FrankenVoron/FT-V/README.md

# FT-V
An unholy mixture of Vorons past and present; a printer only Frankenstein could love.

FT-V
