FrankenVoron/FT-V/FT-V/README.md

# FT-V

The FT-V is a printer born of frustration.

The Folgertech FT-5 is a printer that, by all accounts, was destined for greatness. Numerous design flaws make it mediocre at best, with many pieces needing to be replaced before even the questionably designed internal space can be put to good use.

The machine described in these files is what the FT-5 could have been.

We present... the FrankenVoron. The FT-V.

FT-V
