FrankenVoron/FT-V/FT-V/Phase 2 (Bed Upgrade)/README.md

# FT-V Phase 2 Upgrade
[FT-V BOM Link](https://docs.google.com/spreadsheets/d/1DAGFSrG05QE8Q3-KJ5_f3gPs6uIrWfWeZ_tS3dDz_z8/edit?usp=sharing)
($150 + Phase 1 Cost)
     
     -Replaces warped and underpowered FT-5 bed with MIC6/ATP5 Cast Aluminum Tooling Plate and AC Silicone Heater
     
     -Replaces weak ACM or Melamine bed support with frame from 2020 extrusions
     
     -Utilize up to 360x340mm bed area
