FrankenVoron/FT-V/FT-V/Phase 3 (Z Rod Upgrade)/README.md

# FT-V Phase 3 Upgrade
[FT-V BOM Link](https://docs.google.com/spreadsheets/d/1DAGFSrG05QE8Q3-KJ5_f3gPs6uIrWfWeZ_tS3dDz_z8/edit?usp=sharing)
($100 + Phase 2 + Phase 1)

UNDER DEVELOPMENT
     
     -Upgraded Z Axis
     
     -Improve stability of bed in fore/aft position
     
     -8mm->12mm linear rods and lead screws
     
     -Bed/Z axis changed from Volcom's V1.5 mod to V1.6 style
     
     -Potential to switch to 3 lead screws tied together.
