FrankenVoron/FT-V/FT-V/Phase 1 (CoreXY + Bowden)/Firmware/README.md

# FT-V Firmware

All firmware samples provided are not customized to your printer. Use as a reference only
