FrankenVoron/FT-V/FT-V/Phase 1 (CoreXY + Bowden)/STLs/Bed (V1.5 Volcom Mod)/README.md

# FT-V

This part secures the top of the 8mm linear rods used for the Z axis to the extrusions that the Y rails sit on. 

This design is inspired by the Voron V1.5 "Volcom Mod" design.

Note: This part is different than the one used by Phase 2.
