FrankenVoron/FT-V/FT-V/Phase 1 (CoreXY + Bowden)/STLs/Bed (V1.5 Volcom Mod)/Z_Shaft_Upper_Support_8mm_StandardBed_x4 FT-V.stl

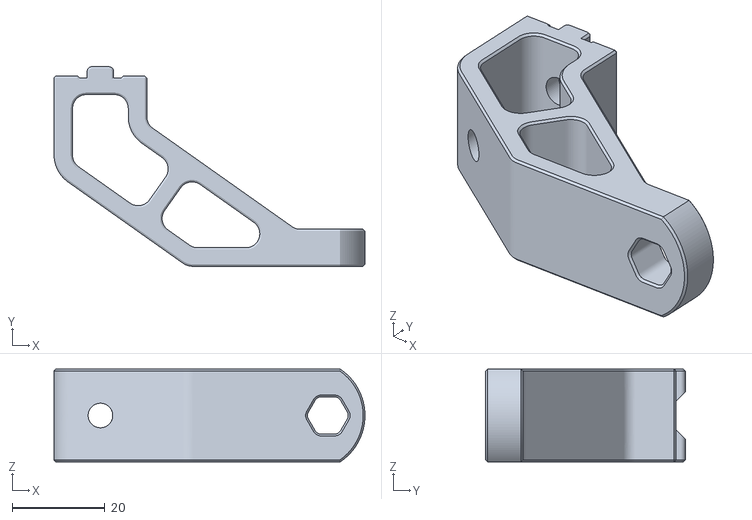
[picture p1: CAD file, 2019-07-24]
FT-V/Phase 1 (CoreXY + Bowden)/STLs/Bed (V1.5 Volcom Mod)/Z_Shaft_Upper_Support_8mm_StandardBed_x4 FT-V.stl
67.0 x 43.0 x 20.0
