FrankenVoron/FT-V/FT-V/Phase 1 (CoreXY + Bowden)/STLs/Gantry (V1.6 and V2.1)/_pulley_spacer_x4.stl

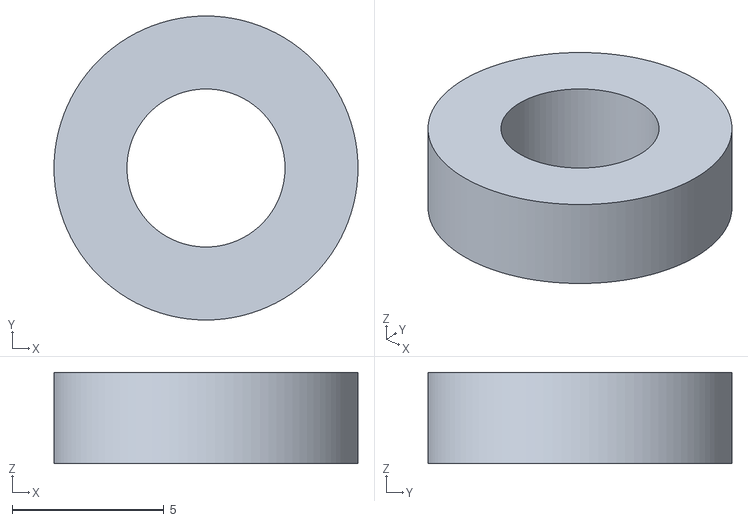
[picture p2: CAD file, 2019-07-24]
FT-V/Phase 1 (CoreXY + Bowden)/STLs/Gantry (V1.6 and V2.1)/_pulley_spacer_x4.stl
10.0 x 10.0 x 3.00
