FrankenVoron/FT-V/FT-V/Phase 1 (CoreXY + Bowden)/STLs/Gantry (V1.6 and V2.1)/AB Drives (V1.6 Mod)/A_Drive_Lower FT-V.stl

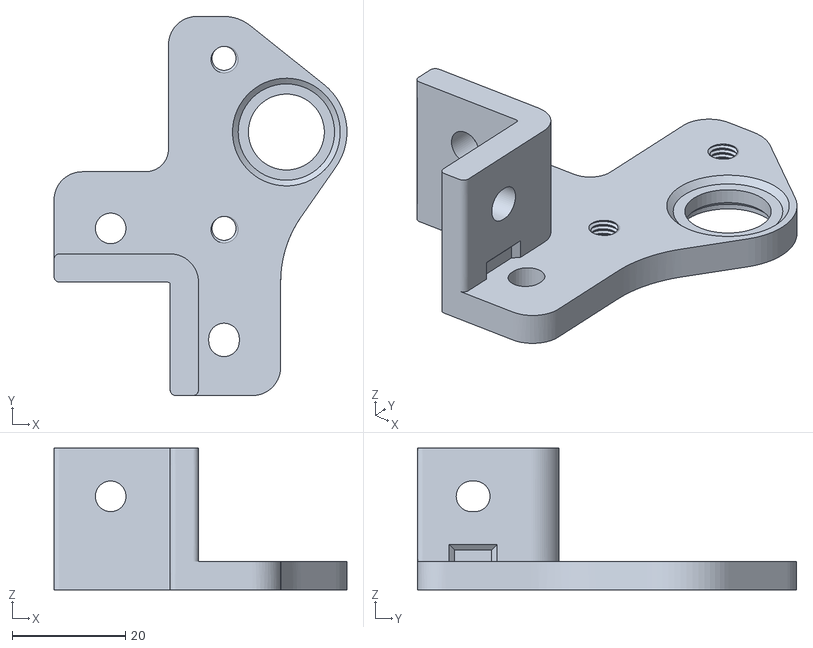
[picture p3: CAD file, 2019-07-24]
FT-V/Phase 1 (CoreXY + Bowden)/STLs/Gantry (V1.6 and V2.1)/AB Drives (V1.6 Mod)/A_Drive_Lower FT-V.stl
51.7 x 66.9 x 25.0
