FrankenVoron/FT-V/FT-V/Phase 1 (CoreXY + Bowden)/STLs/Gantry (V1.6 and V2.1)/X Carriage (V2.1 Mod)/Toolhead/Mosquito Hotend Sock/mosquito_sock_mold_top.stl

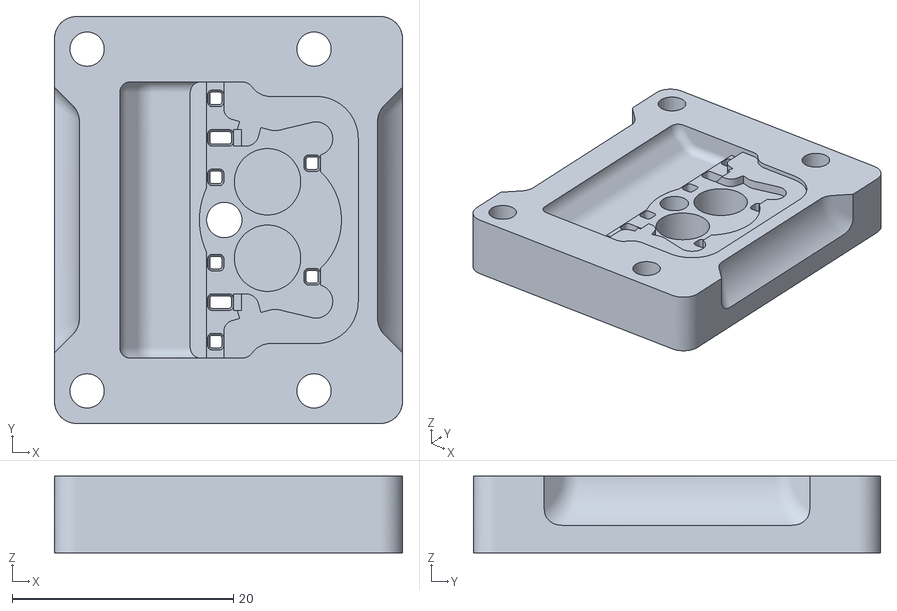
[picture p5: CAD file, 2019-07-24]
FT-V/Phase 1 (CoreXY + Bowden)/STLs/Gantry (V1.6 and V2.1)/X Carriage (V2.1 Mod)/Toolhead/Mosquito Hotend Sock/mosquito_sock_mold_top.stl
31.5 x 36.8 x 6.95
