FrankenVoron/FT-V/FT-V/Phase 1 (CoreXY + Bowden)/STLs/Gantry (V1.6 and V2.1)/X Carriage (V2.1 Mod)/Toolhead/v6_toolhead_housing_rear.STL

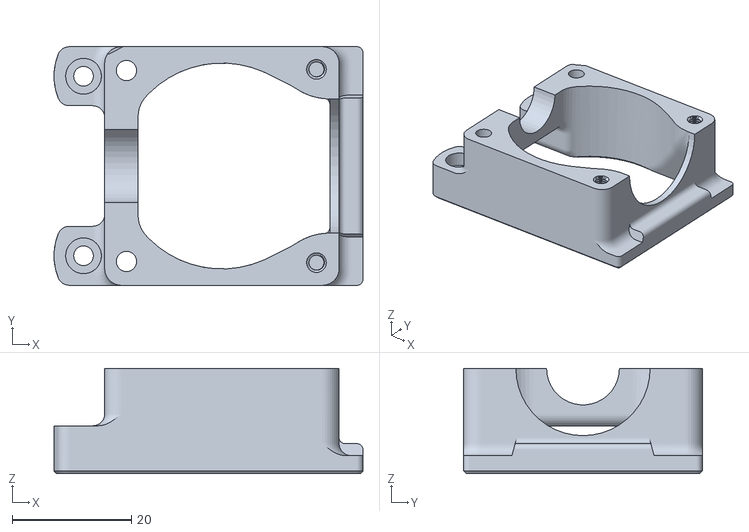
[picture p6: CAD file, 2019-07-24]
FT-V/Phase 1 (CoreXY + Bowden)/STLs/Gantry (V1.6 and V2.1)/X Carriage (V2.1 Mod)/Toolhead/v6_toolhead_housing_rear.STL
51.8 x 40.0 x 17.6
