FrankenVoron/FT-V/FT-V/Phase 1 (CoreXY + Bowden)/STLs/Gantry (V1.6 and V2.1)/X Carriage (V2.1 Mod)/X_Carriage_Frame_Left FT-V.stl

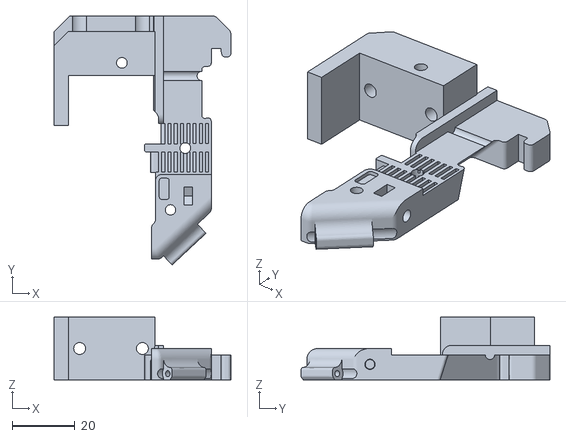
[picture p7: CAD file, 2019-07-24]
FT-V/Phase 1 (CoreXY + Bowden)/STLs/Gantry (V1.6 and V2.1)/X Carriage (V2.1 Mod)/X_Carriage_Frame_Left FT-V.stl
56.4 x 79.4 x 20.0
