FrankenVoron/FT-V/FT-V/Phase 1 (CoreXY + Bowden)/STLs/Gantry (V1.6 and V2.1)/XY Joints (V2.1 Mod)/XY_Joint_backbrace_left FT-V.stl

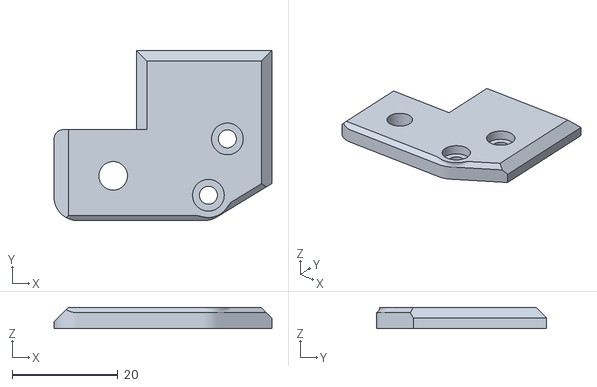
[picture p8: CAD file, 2019-07-24]
FT-V/Phase 1 (CoreXY + Bowden)/STLs/Gantry (V1.6 and V2.1)/XY Joints (V2.1 Mod)/XY_Joint_backbrace_left FT-V.stl
41.3 x 32.2 x 4.00
