FrankenVoron/FT-V/FT-V/Phase 2 (Bed Upgrade)/STLs/Bed (V1.5 Volcom Mod)/Z_Shaft_Upper_Support_8mm_Phase2_x4 FT-V.stl

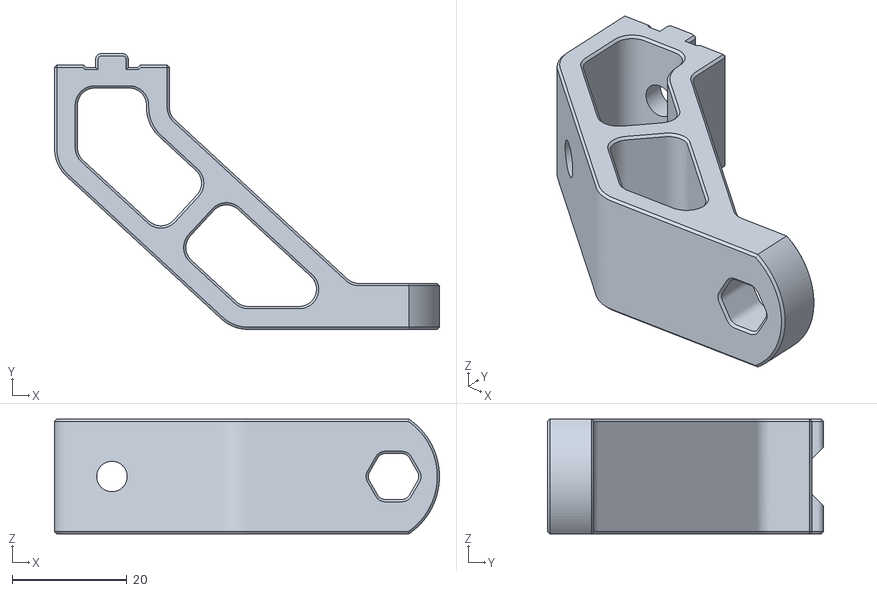
[picture p9: CAD file, 2019-07-24]
FT-V/Phase 2 (Bed Upgrade)/STLs/Bed (V1.5 Volcom Mod)/Z_Shaft_Upper_Support_8mm_Phase2_x4 FT-V.stl
67.0 x 48.0 x 20.0
