FrankenVoron/FT-V/FT-V/Phase X (Optional Upgrades and Mods)/Direct Drive BMG/Direct_Drive_BMG_Mount_15mm_Offset.stl

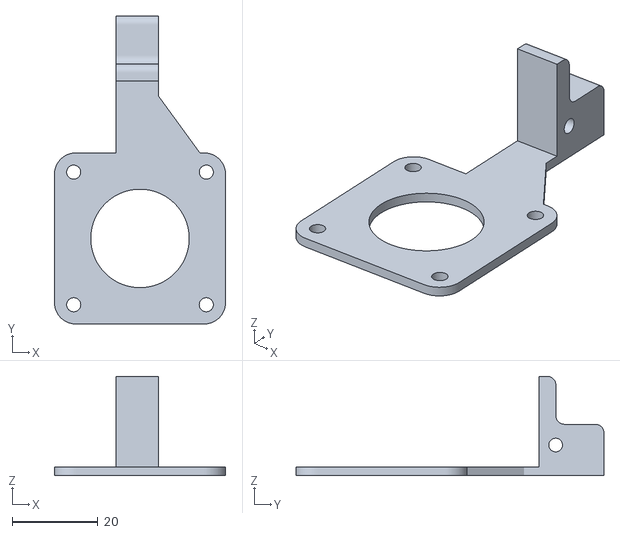
[picture p10: CAD file, 2019-08-08]
FT-V/Phase X (Optional Upgrades and Mods)/Direct Drive BMG/Direct_Drive_BMG_Mount_15mm_Offset.stl
40.0 x 72.0 x 23.2
