FrankenVoron/FT-V/FT-V/Phase 1 (CoreXY + Bowden)/STLs/Gantry (V1.6 and V2.1)/AB Drives (V1.6 Mod)/A_Drive_Upper FT-V.stl

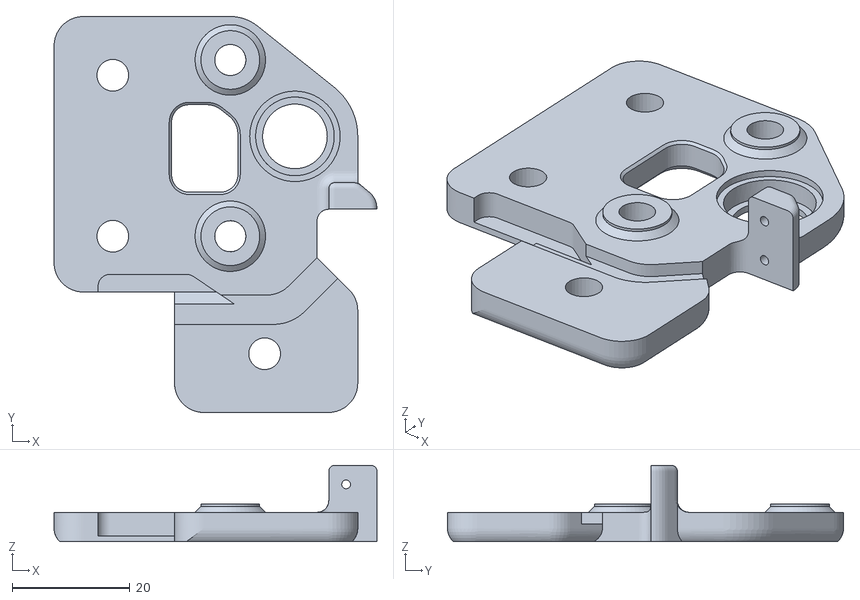
[picture p11: CAD file, 2019-07-24]
FT-V/Phase 1 (CoreXY + Bowden)/STLs/Gantry (V1.6 and V2.1)/AB Drives (V1.6 Mod)/A_Drive_Upper FT-V.stl
55.0 x 67.4 x 13.0
