FrankenVoron/FT-V/FT-V/Phase 1 (CoreXY + Bowden)/STLs/Gantry (V1.6 and V2.1)/Front Idlers (V2.1 Mod)/_front_tensioner_cap_lower_right.stl

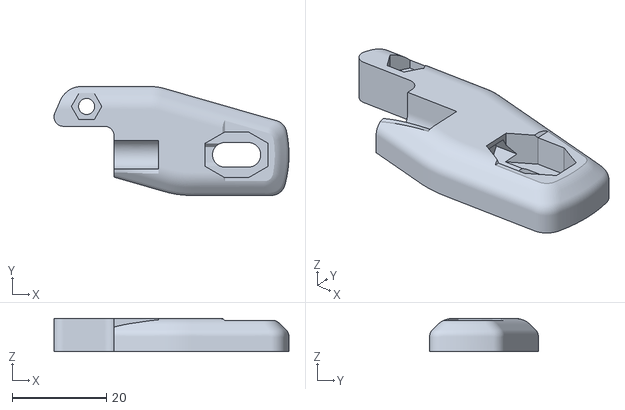
[picture p12: CAD file, 2019-07-24]
FT-V/Phase 1 (CoreXY + Bowden)/STLs/Gantry (V1.6 and V2.1)/Front Idlers (V2.1 Mod)/_front_tensioner_cap_lower_right.stl
49.8 x 23.1 x 7.00
