FrankenVoron/FT-V/FT-V/Phase 1 (CoreXY + Bowden)/STLs/Gantry (V1.6 and V2.1)/X Carriage (V2.1 Mod)/Toolhead/Mosquito Hotend Sock/mosquito_sock_core_top.stl

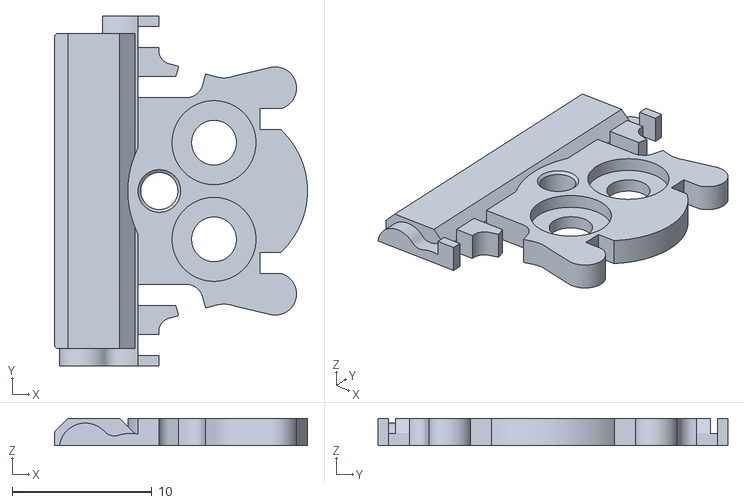
[picture p14: CAD file, 2019-07-24]
FT-V/Phase 1 (CoreXY + Bowden)/STLs/Gantry (V1.6 and V2.1)/X Carriage (V2.1 Mod)/Toolhead/Mosquito Hotend Sock/mosquito_sock_core_top.stl
18.1 x 25.0 x 1.96
