FrankenVoron/FT-V/FT-V/Phase 1 (CoreXY + Bowden)/STLs/Gantry (V1.6 and V2.1)/X Carriage (V2.1 Mod)/Toolhead/volcano_cooling_fan_duct_left.STL

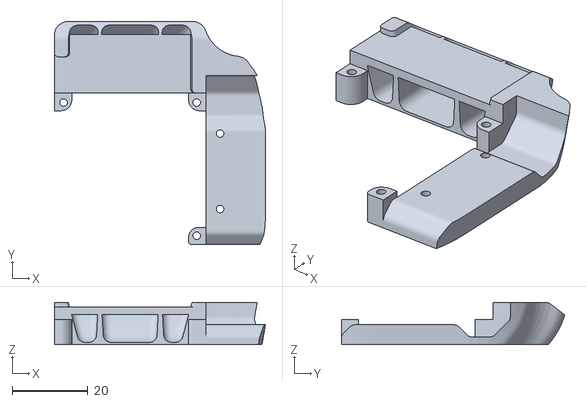
[picture p15: CAD file, 2019-07-24]
FT-V/Phase 1 (CoreXY + Bowden)/STLs/Gantry (V1.6 and V2.1)/X Carriage (V2.1 Mod)/Toolhead/volcano_cooling_fan_duct_left.STL
55.8 x 59.1 x 11.1
