FrankenVoron/FT-V/FT-V/Phase 1 (CoreXY + Bowden)/STLs/Gantry (V1.6 and V2.1)/XY Joints (V2.1 Mod)/xy_joint_backbrace_right.stl

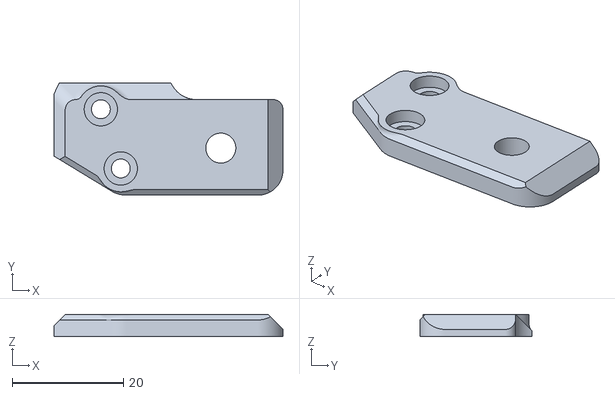
[picture p17: CAD file, 2019-07-24]
FT-V/Phase 1 (CoreXY + Bowden)/STLs/Gantry (V1.6 and V2.1)/XY Joints (V2.1 Mod)/xy_joint_backbrace_right.stl
41.3 x 20.2 x 4.00
