FrankenVoron/FT-V/FT-V/Phase X (Optional Upgrades and Mods)/Direct Drive BMG/Direct_Drive_BMG_Mount.stl

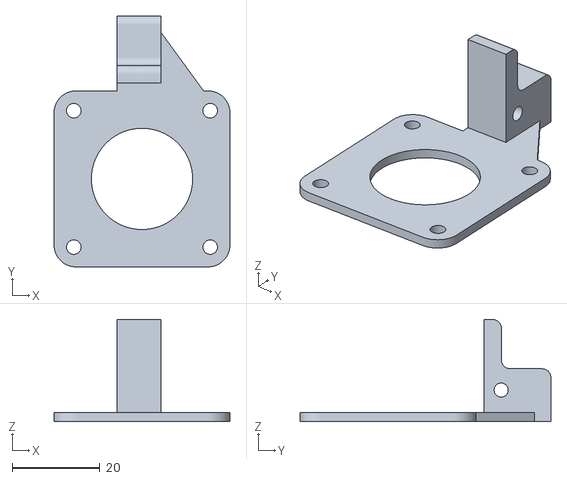
[picture p18: CAD file, 2019-08-08]
FT-V/Phase X (Optional Upgrades and Mods)/Direct Drive BMG/Direct_Drive_BMG_Mount.stl
40.0 x 57.0 x 23.2
