FrankenVoron/FT-V/FT-V/Phase 1 (CoreXY + Bowden)/STLs/Gantry (V1.6 and V2.1)/_large_bearing_spacer_x4.stl

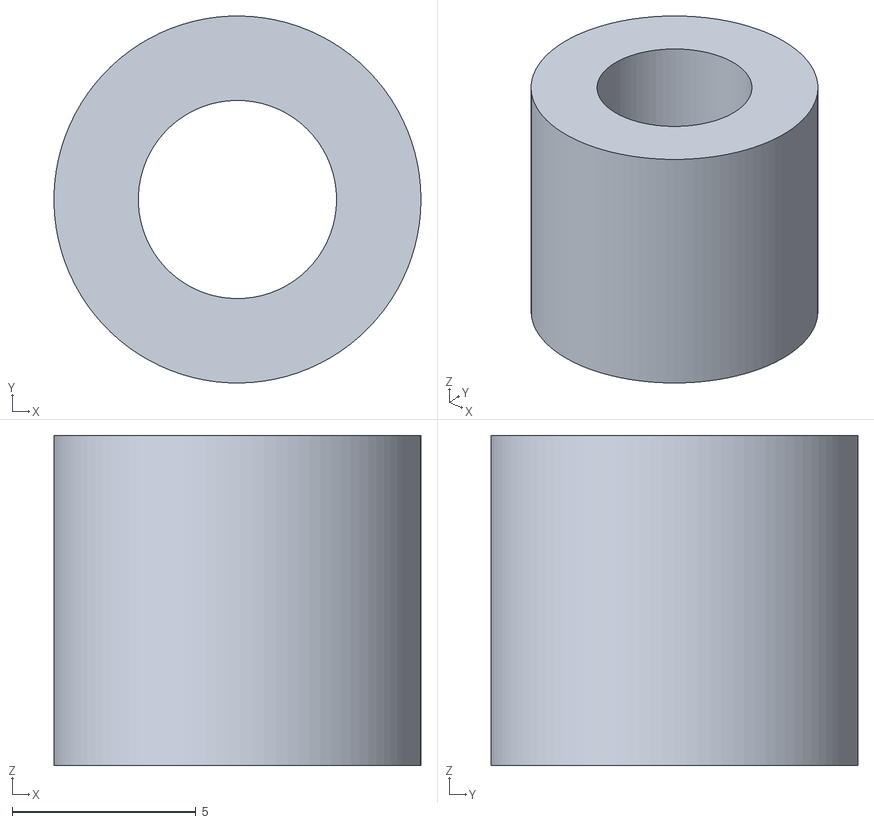
[picture p19: CAD file, 2019-07-24]
FT-V/Phase 1 (CoreXY + Bowden)/STLs/Gantry (V1.6 and V2.1)/_large_bearing_spacer_x4.stl
10.00 x 10.00 x 9.00
