FrankenVoron/FT-V/FT-V/Phase 1 (CoreXY + Bowden)/STLs/Gantry (V1.6 and V2.1)/AB Drives (V1.6 Mod)/B_Drive_Upper FT-V.stl

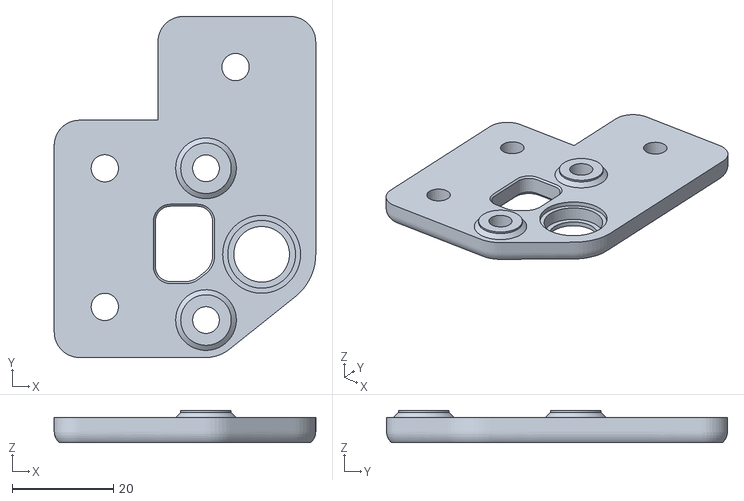
[picture p20: CAD file, 2019-07-24]
FT-V/Phase 1 (CoreXY + Bowden)/STLs/Gantry (V1.6 and V2.1)/AB Drives (V1.6 Mod)/B_Drive_Upper FT-V.stl
51.7 x 67.4 x 6.40
