FrankenVoron/FT-V/FT-V/Phase 1 (CoreXY + Bowden)/STLs/Gantry (V1.6 and V2.1)/X Carriage (V2.1 Mod)/Toolhead/Mosquito Hotend Sock/mosquito_sock_mold_bottom.stl

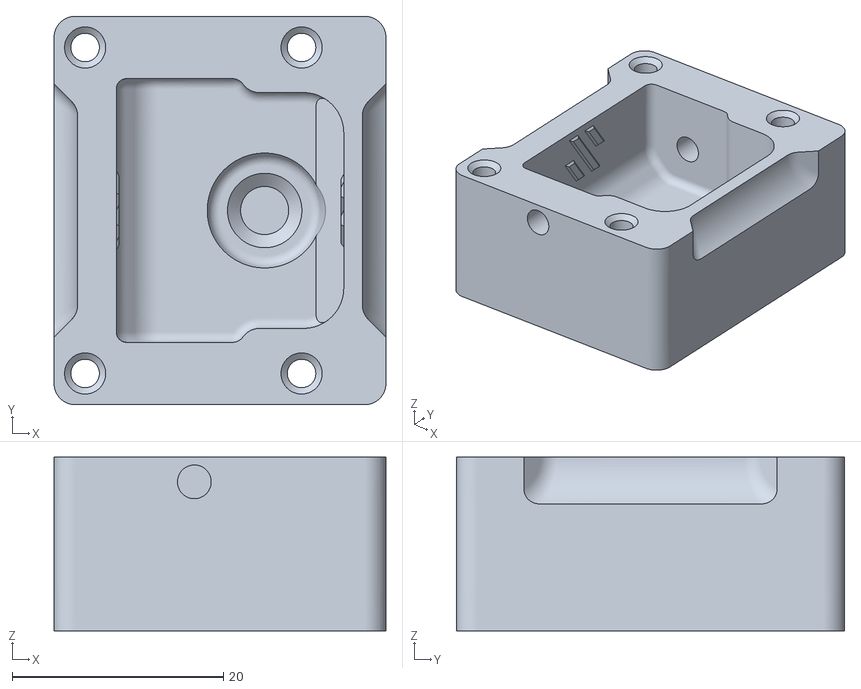
[picture p21: CAD file, 2019-07-24]
FT-V/Phase 1 (CoreXY + Bowden)/STLs/Gantry (V1.6 and V2.1)/X Carriage (V2.1 Mod)/Toolhead/Mosquito Hotend Sock/mosquito_sock_mold_bottom.stl
31.5 x 36.8 x 16.5
