FrankenVoron/FT-V/FT-V/Phase 2 (Bed Upgrade)/STLs/Bed (V1.5 Volcom Mod)/Z_Bed_Bracket_B_Phase2_x2 FT-V.stl

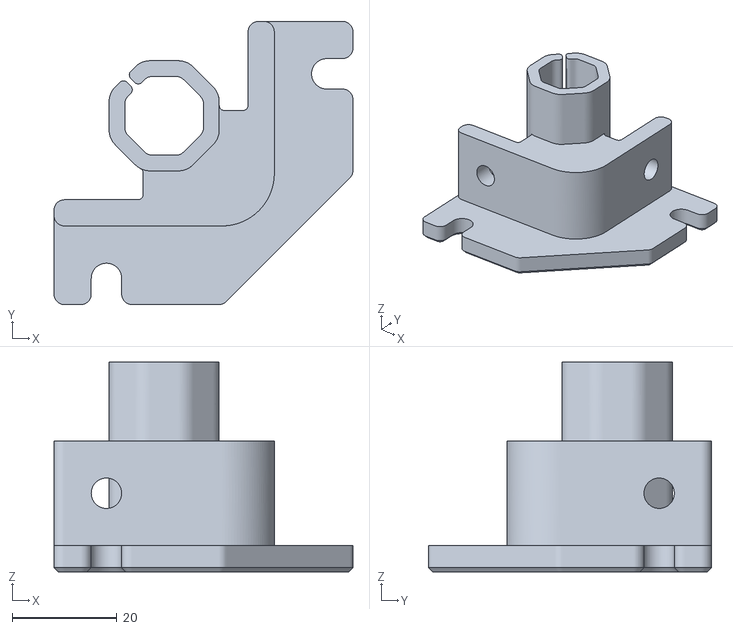
[picture p24: CAD file, 2019-07-24]
FT-V/Phase 2 (Bed Upgrade)/STLs/Bed (V1.5 Volcom Mod)/Z_Bed_Bracket_B_Phase2_x2 FT-V.stl
57.0 x 54.0 x 40.0
