FrankenVoron/FT-V/FT-V/Phase X (Optional Upgrades and Mods)/Direct Drive BMG/X_Carriage_Frame_Right_Direct_MGN12.stl

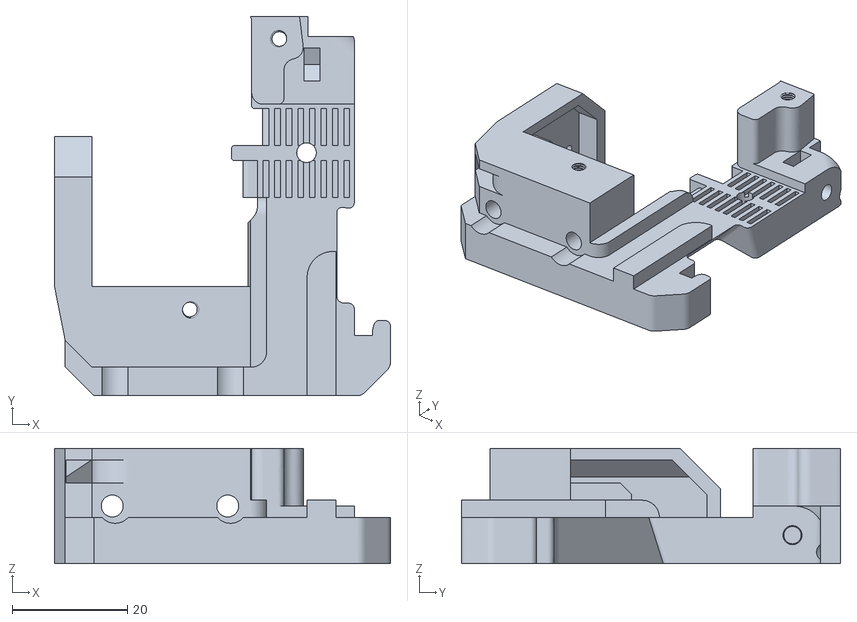
[picture p25: CAD file, 2019-07-26]
FT-V/Phase X (Optional Upgrades and Mods)/Direct Drive BMG/X_Carriage_Frame_Right_Direct_MGN12.stl
58.2 x 65.7 x 20.0
