FrankenVoron/FT-V/FT-V/Phase 1 (CoreXY + Bowden)/STLs/Gantry (V1.6 and V2.1)/AB Drives (V1.6 Mod)/a_motor_mount.stl

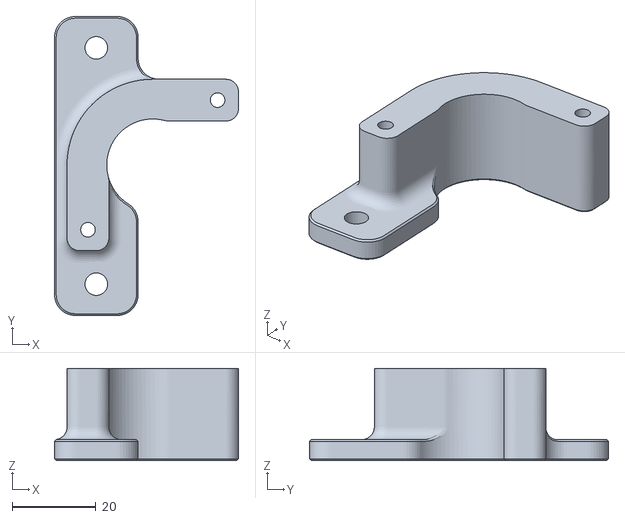
[picture p26: CAD file, 2019-07-24]
FT-V/Phase 1 (CoreXY + Bowden)/STLs/Gantry (V1.6 and V2.1)/AB Drives (V1.6 Mod)/a_motor_mount.stl
44.0 x 71.5 x 22.0
