FrankenVoron/FT-V/FT-V/Phase 1 (CoreXY + Bowden)/STLs/Gantry (V1.6 and V2.1)/Front Idlers (V2.1 Mod)/Idler_Frame_A_x2 FT-V.stl

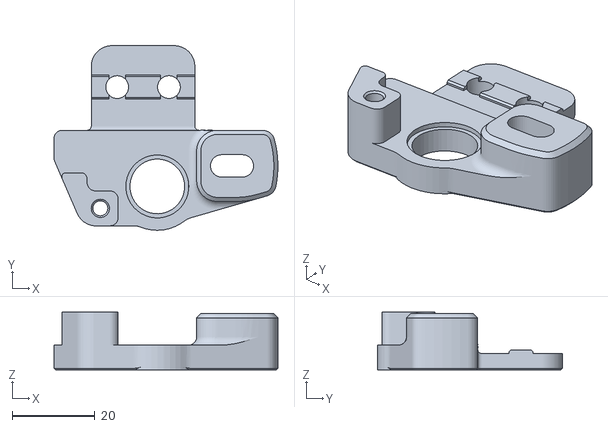
[picture p27: CAD file, 2019-07-24]
FT-V/Phase 1 (CoreXY + Bowden)/STLs/Gantry (V1.6 and V2.1)/Front Idlers (V2.1 Mod)/Idler_Frame_A_x2 FT-V.stl
54.1 x 44.6 x 14.0
