FrankenVoron/FT-V/FT-V/Phase 1 (CoreXY + Bowden)/STLs/Gantry (V1.6 and V2.1)/X Carriage (V2.1 Mod)/Toolhead/Mosquito Hotend Sock/mosquito_sock_core_bottom.stl

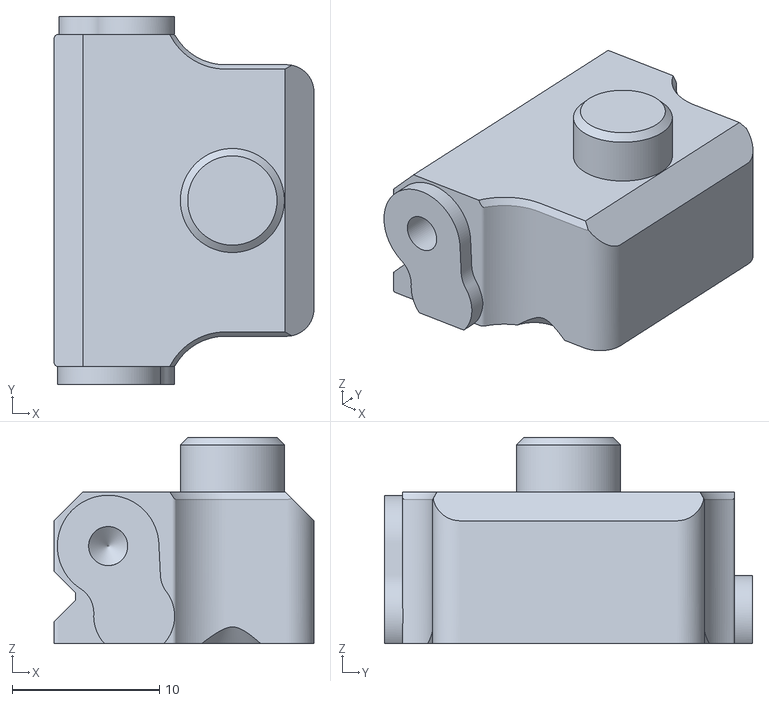
[picture p28: CAD file, 2019-07-24]
FT-V/Phase 1 (CoreXY + Bowden)/STLs/Gantry (V1.6 and V2.1)/X Carriage (V2.1 Mod)/Toolhead/Mosquito Hotend Sock/mosquito_sock_core_bottom.stl
17.6 x 25.0 x 14.0
