FrankenVoron/FT-V/FT-V/Phase 1 (CoreXY + Bowden)/STLs/Gantry (V1.6 and V2.1)/XY Joints (V2.1 Mod)/xy_topbrace_right.stl

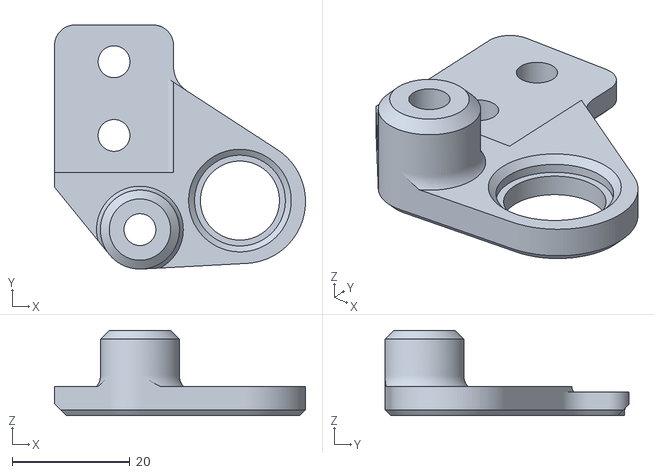
[picture p31: CAD file, 2019-07-24]
FT-V/Phase 1 (CoreXY + Bowden)/STLs/Gantry (V1.6 and V2.1)/XY Joints (V2.1 Mod)/xy_topbrace_right.stl
42.6 x 41.4 x 14.5
