FrankenVoron/FT-V/FT-V/Phase X (Optional Upgrades and Mods)/Direct Drive BMG/X_Carriage_Frame_Right_Direct_MGN9.stl

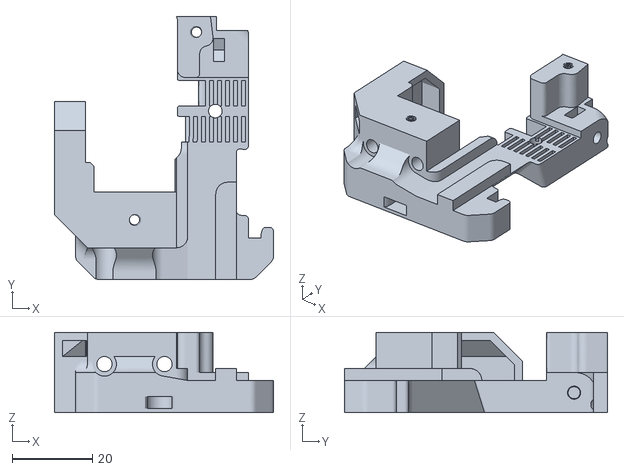
[picture p32: CAD file, 2019-07-26]
FT-V/Phase X (Optional Upgrades and Mods)/Direct Drive BMG/X_Carriage_Frame_Right_Direct_MGN9.stl
54.8 x 65.7 x 20.0
