FrankenVoron/FT-V/FT-V/Phase 1 (CoreXY + Bowden)/STLs/Gantry (V1.6 and V2.1)/XY Joints (V2.1 Mod)/XY_Joint_Right FT-V.stl

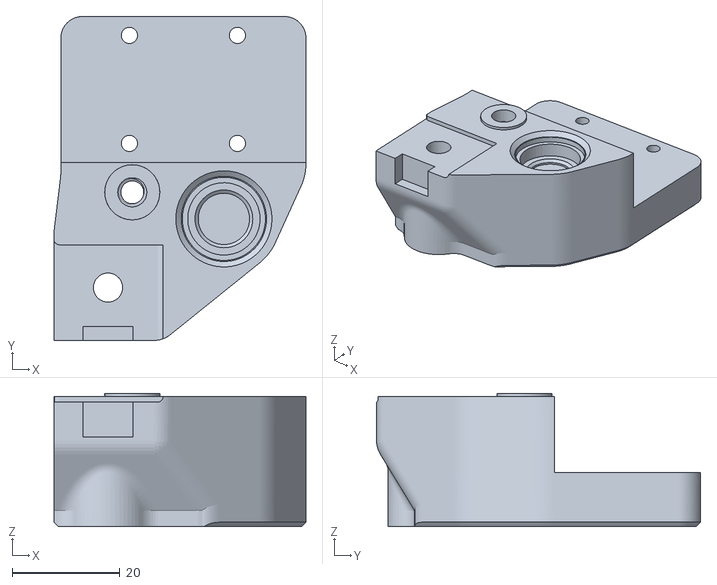
[picture p36: CAD file, 2019-07-24]
FT-V/Phase 1 (CoreXY + Bowden)/STLs/Gantry (V1.6 and V2.1)/XY Joints (V2.1 Mod)/XY_Joint_Right FT-V.stl
46.7 x 60.0 x 24.7
