FrankenVoron/FT-V/FT-V/Phase 2 (Bed Upgrade)/STLs/Bed (V1.5 Volcom Mod)/Bed_Mount_Phase2_x3 FT-V.stl

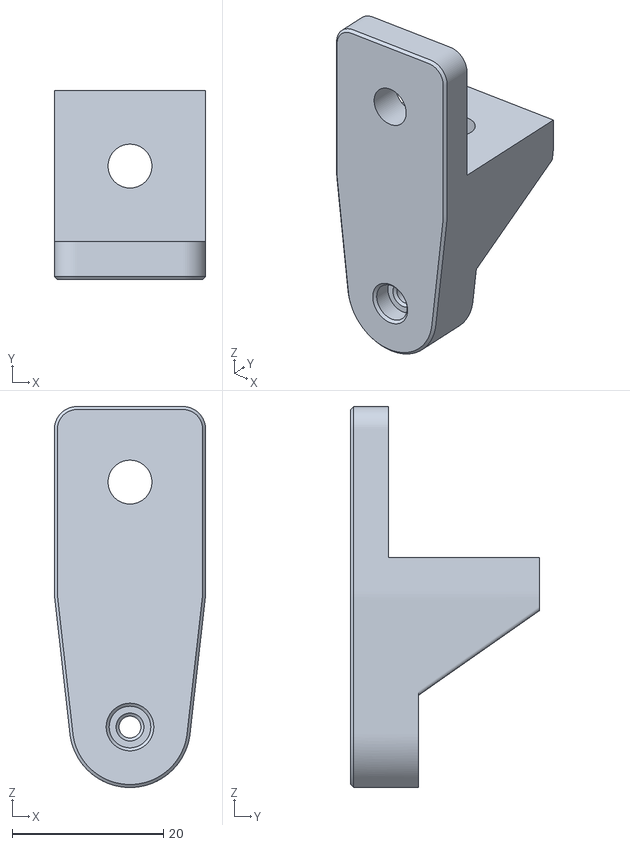
[picture p37: CAD file, 2019-07-24]
FT-V/Phase 2 (Bed Upgrade)/STLs/Bed (V1.5 Volcom Mod)/Bed_Mount_Phase2_x3 FT-V.stl
20.0 x 25.0 x 50.4
