FrankenVoron/FT-V/FT-V/Phase X (Optional Upgrades and Mods)/Direct Drive BMG/X_Carriage_Frame_Left_Direct_MGN9.stl

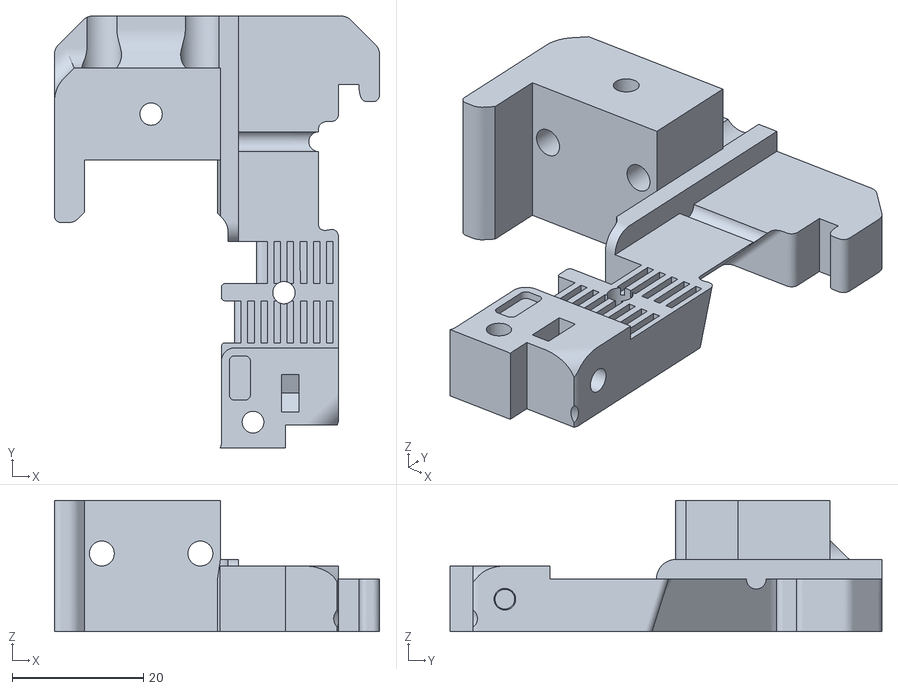
[picture p38: CAD file, 2019-07-26]
FT-V/Phase X (Optional Upgrades and Mods)/Direct Drive BMG/X_Carriage_Frame_Left_Direct_MGN9.stl
49.5 x 65.7 x 20.0
