FrankenVoron/FT-V/FT-V/Phase X (Optional Upgrades and Mods)/Direct Drive BMG/X_Carriage_Frame_Left_Direct_MGN12.stl

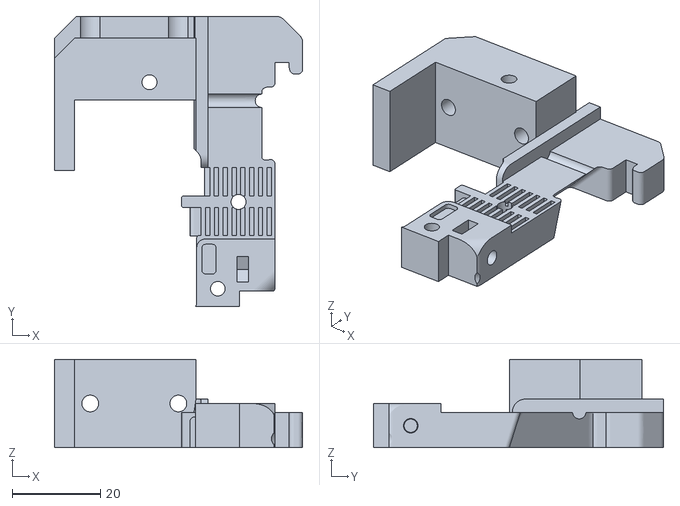
[picture p41: CAD file, 2019-07-26]
FT-V/Phase X (Optional Upgrades and Mods)/Direct Drive BMG/X_Carriage_Frame_Left_Direct_MGN12.stl
56.4 x 65.8 x 20.0
