FrankenVoron/FT-V/FT-V/Phase 1 (CoreXY + Bowden)/STLs/Gantry (V1.6 and V2.1)/X Carriage (V2.1 Mod)/Toolhead/v6_+_mosquito_cooling_fan_duct_right.STL

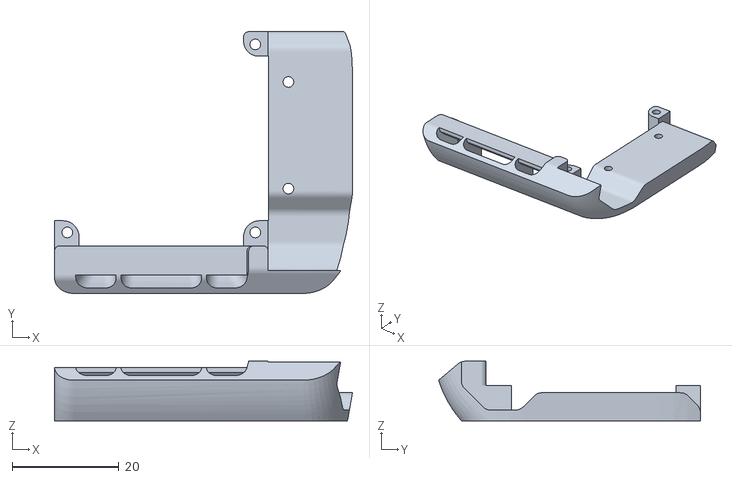
[picture p43: CAD file, 2019-07-24]
FT-V/Phase 1 (CoreXY + Bowden)/STLs/Gantry (V1.6 and V2.1)/X Carriage (V2.1 Mod)/Toolhead/v6_+_mosquito_cooling_fan_duct_right.STL
55.8 x 49.0 x 11.1
