FrankenVoron/FT-V/(list of files, cad)

Other CAD files:
FT-V/Phase 1 (CoreXY + Bowden)/STLs/Gantry (V1.6 and V2.1)/Front Idlers (V2.1 Mod)/_front_tensioner_cap_upper_left.stl
FT-V/Phase 1 (CoreXY + Bowden)/STLs/Gantry (V1.6 and V2.1)/X Carriage (V2.1 Mod)/Toolhead/volcano_cooling_fan_duct_right.STL
FT-V/Phase 2 (Bed Upgrade)/STLs/Bed (V1.5 Volcom Mod)/Z_Bed_Bracket_A_Phase2_x2 FT-V.stl
FT-V/Phase 1 (CoreXY + Bowden)/STLs/Gantry (V1.6 and V2.1)/AB Drives (V1.6 Mod)/B_Drive_Lower FT-V.stl
FT-V/Phase 1 (CoreXY + Bowden)/STLs/Gantry (V1.6 and V2.1)/Front Idlers (V2.1 Mod)/_front_tensioner_cap_lower_left.stl
FT-V/Phase 1 (CoreXY + Bowden)/STLs/Gantry (V1.6 and V2.1)/AB Drives (V1.6 Mod)/b_motor_mount.stl
FT-V/Phase 1 (CoreXY + Bowden)/STLs/Gantry (V1.6 and V2.1)/Front Idlers (V2.1 Mod)/_front_tensioner_cap_upper_right.stl
FT-V/Phase 1 (CoreXY + Bowden)/STLs/Gantry (V1.6 and V2.1)/X Carriage (V2.1 Mod)/Toolhead/v6_+_mosquito_cooling_fan_duct_left.STL
FT-V/Phase 1 (CoreXY + Bowden)/STLs/Gantry (V1.6 and V2.1)/X Carriage (V2.1 Mod)/Cable_Cover_Left_ScrewMod.stl
FT-V/Phase 1 (CoreXY + Bowden)/STLs/Gantry (V1.6 and V2.1)/X Carriage (V2.1 Mod)/Cable_Cover_Right_ScrewMod.stl
FT-V/Phase 2 (Bed Upgrade)/STLs/Bed (V1.5 Volcom Mod)/LeadScrew_Mount_Phase2_x2 FT-V.stl
