FrankenVoron/FT-V/FT-V/Phase 1 (CoreXY + Bowden)/STLs/Gantry (V1.6 and V2.1)/X Carriage (V2.1 Mod)/Toolhead/Mosquito Hotend Sock/mosquito_sock_mold_assembly_drawing.pdf

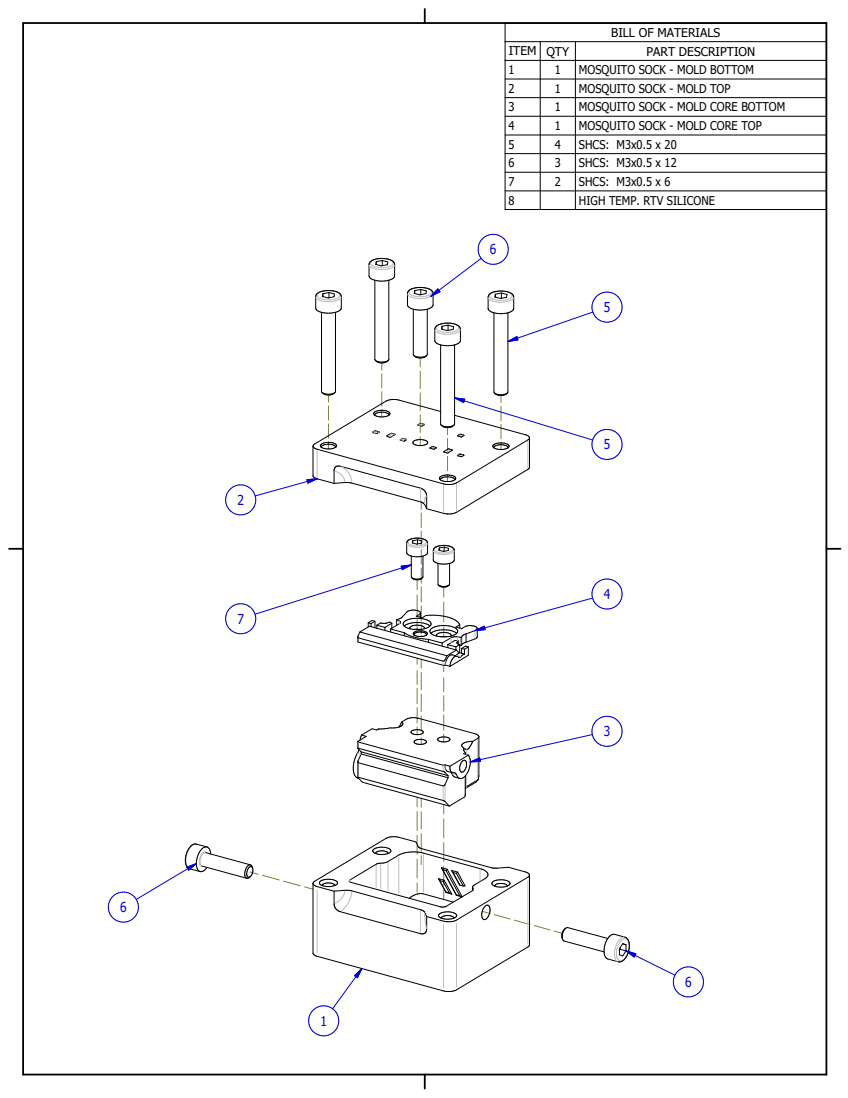
[picture p52: page 1]

BILL OF MATERIALS

ITEM | QTY | PART DESCRIPTION
1 | 1 | MOSQUITO SOCK - MOLD BOTTOM
2 | 1 | MOSQUITO SOCK - MOLD TOP
3 | 1 | MOSQUITO SOCK - MOLD CORE BOTTOM
4 | 1 | MOSQUITO SOCK - MOLD CORE TOP
5 | 4 | SHCS: M3x0.5 x 20
6 | 3 | SHCS: M3x0.5 x 12
7 | 2 | SHCS: M3x0.5 x 6
8 | | HIGH TEMP. RTV SILICONE

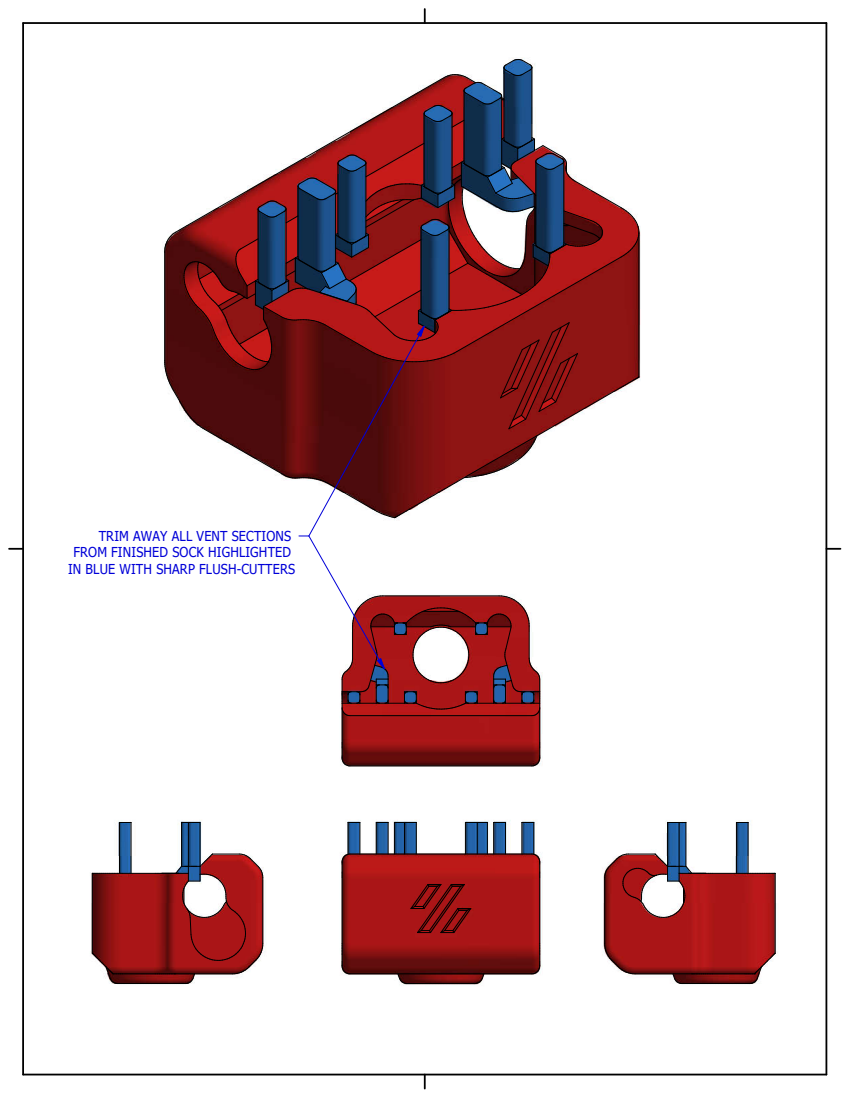
[picture p53: page 2]

TRIM AWAY ALL VENT SECTIONS
FROM FINISHED SOCK HIGHLIGHTED
IN BLUE WITH SHARP FLUSH-CUTTERS

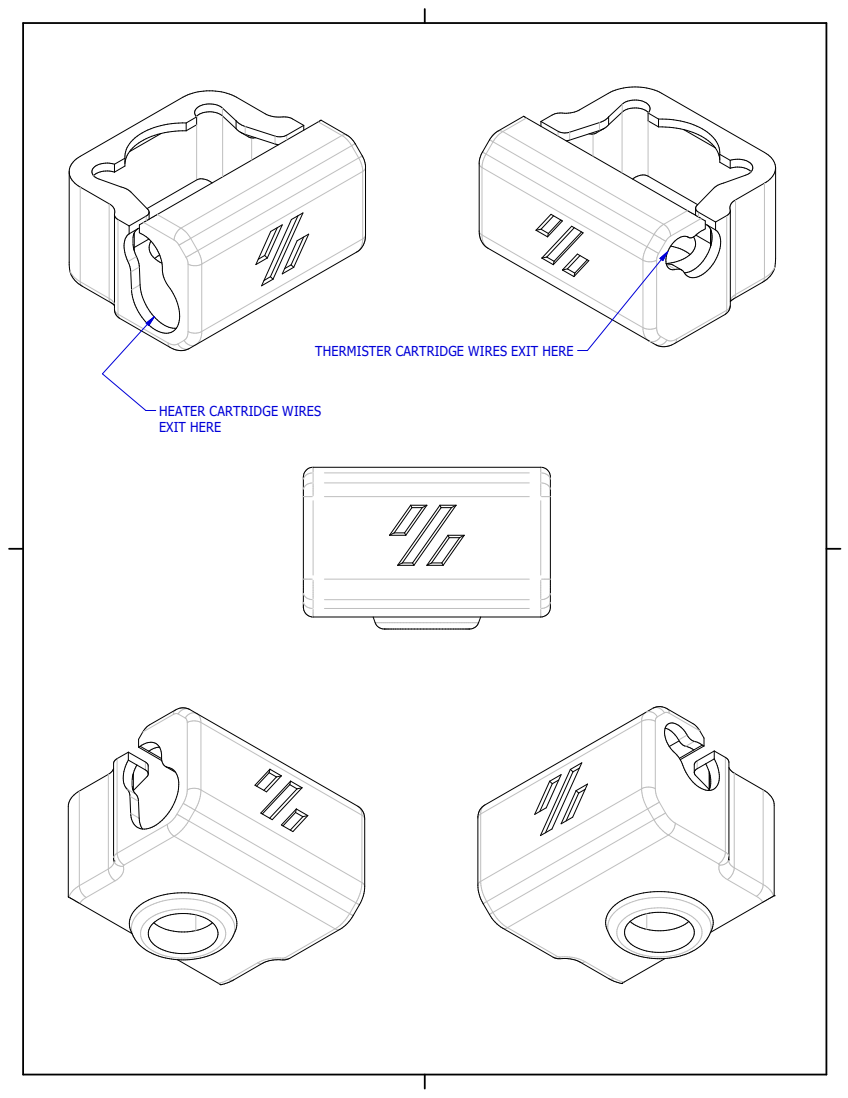
[picture p54: page 3]

THERMISTER CARTRIDGE WIRES EXIT HERE

HEATER CARTRIDGE WIRES
EXIT HERE
