FrankenVoron/FT-V/(commit log)

2019-07-24 Add all FT-V STLs to Github
    Uploaded and organized all FT-V upgrades for Phase 1 and 2
    Signed off by Joshua Longenecker - jdlongenecker@gmail.com
    [A_Drive_Lower FT-V.stl, A_Drive_Upper FT-V.stl, B_Drive_Lower FT-V.stl, B_Drive_Upper FT-V.stl, Bed_Mount_Phase2_x3 FT-V.stl, Cable_Cover_Left_ScrewMod.stl, Cable_Cover_Right_ScrewMod.stl, GantryBracket.stl]
2019-07-24 Update spacing and add BOM Link
2019-07-24 Updated with BOM link, formatting
2019-07-24 Assembly Notes and Firmware
    Adding assembly notes and firmware for Klipper/SKR1.3/TMC2209.
    Joshua Longenecker - jdlongenecker@gmail.com
2019-07-24 Add bearing spacers from V1.6 for A/B Modules
    Joshua Longenecker
    jdlongenecker@gmail.com
    [_large_bearing_spacer_x4.stl, _pulley_spacer_x4.stl, small_bearing_spacer_x4.stl]
2019-07-26 Add direct drive BMG extruder Mod
    This mod is untested, but will be printed and tested by a few people shortly.
    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
    [Direct_Drive_BMG_Mount.stl, X_Carriage_Frame_Left_Direct_MGN12.stl, X_Carriage_Frame_Left_Direct_MGN9.stl, X_Carriage_Frame_Right_Direct_MGN12.stl, X_Carriage_Frame_Right_Direct_MGN9.stl]
2019-07-26 Removed slash from file name
    [Direct_Drive_BMG_Mount.stl, X_Carriage_Frame_Left_Direct_MGN12.stl, X_Carriage_Frame_Left_Direct_MGN9.stl, X_Carriage_Frame_Right_Direct_MGN12.stl, X_Carriage_Frame_Right_Direct_MGN9.stl]
2019-08-08 Update BMG mount due to clearance issue
    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
    [Direct_Drive_BMG_Mount.stl, Direct_Drive_BMG_Mount_15mm_Offset.stl]
